Yyymira/TTGO-Macropad/docs/schematic.en.html

English | Español

# Schematic — TTGO Macropad

What goes to each GPIO of the TTGO T-Display for the 10 buttons (6 Cherry MX, the board's 2 built-in buttons and each encoder's push switch) and the rotation of the 2 encoders. Everything is soldered straight to the switch pins, against the same GND bus.

The T-Display's ESP32 in the center, with the 6 Cherry MX keys and the 2 built-in buttons against the GND bus on the left, and the 2 EC11 encoders against the one on the right. The built-in ones (dashed grey) are already on the board; the case presses them with printed plungers.

GPIO to wire Already built into the board Shared GND bus Pin / junction

## Connection table

GPIO | Component | Other terminal | Note
GPIO32 | KEY 1 | GND | Cherry MX, back row, left.
GPIO33 | KEY 2 | GND | Cherry MX, back row, center.
GPIO25 | KEY 3 | GND | Cherry MX, back row, right.
GPIO26 | KEY 4 | GND | Cherry MX, front row, left.
GPIO13 | KEY 5 | GND | Cherry MX, front row, center.
GPIO17 | KEY 6 | GND | Cherry MX, front row, right.
GPIO0 | BOARD 7 | GND | Built in. Don't hold it while resetting/plugging in USB.
GPIO35 | BOARD 8 | GND | Built in.
GPIO27 | ENC 1 · CLK | GND (del encoder) | Back encoder, signal A.
GPIO12 | ENC 1 · DT | GND (del encoder) | Back encoder, signal B.
GPIO21 | ENC 2 · CLK | GND (del encoder) | Front encoder, signal A.
GPIO22 | ENC 2 · DT | GND (del encoder) | Front encoder, signal B.
GPIO15 | ENC 1 · SW | GND | Back encoder's shaft switch (button 9).
GPIO2 | ENC 2 · SW | GND | Front encoder's shaft switch (button 10).

## Parts list

- 6× Cherry MX switches (Brown), plate mount, snapped into the case lid.
- 2× EC11 rotary encoders, preferably with a push switch (3 rotation pins: A – C – B, with C to GND; 2 switch pins). If yours has 3 pins (no switch), don't wire GPIO15 or GPIO2: everything else works the same and buttons 9 and 10 just aren't used.
- Thin wire to solder straight to the pins (no PCB).

## Notes

- Every switch goes to GND using the ESP32's internal pull-up — no resistors or diodes (each key has its own GPIO, there's no matrix).
- The encoders use the same internal pull-up through ESP32Encoder.
- GPIO0 is also the boot button: if you hold it while plugging in USB, the board enters flashing mode instead of booting normally.
- GPIO12, GPIO15 and GPIO2 are also read at boot, but the encoder and the switches only pull them to GND: when released they change nothing. Don't hold encoder 2 pressed while flashing.

Full details and the list of pins free for future use in docs/wiring.en.md, inside ttgo-macropad/.
