Yyymira/TTGO-Macropad/docs/schematic.html

English | Español

# Esquemático — TTGO Macropad

Qué va a cada GPIO del TTGO T-Display para los 10 botones (6 Cherry MX, los 2 integrados de la placa y el pulsador de cada encoder) y el giro de los 2 encoders. Todo se suelda directo a los pines de los switches, contra el mismo bus de GND.

El ESP32 del T-Display al centro, con las 6 teclas Cherry MX y los 2 botones integrados contra el bus de GND de la izquierda, y los 2 encoders EC11 contra el de la derecha. Los integrados (gris punteado) ya están en la placa; el gabinete los acciona con pulsadores impresos.

GPIO a cablear Ya integrado en la placa Bus de GND común Pin / unión

## Tabla de conexión

GPIO | Componente | Otro terminal | Nota
GPIO32 | TECLA 1 | GND | Cherry MX, fila de atrás, izquierda.
GPIO33 | TECLA 2 | GND | Cherry MX, fila de atrás, centro.
GPIO25 | TECLA 3 | GND | Cherry MX, fila de atrás, derecha.
GPIO26 | TECLA 4 | GND | Cherry MX, fila de adelante, izquierda.
GPIO13 | TECLA 5 | GND | Cherry MX, fila de adelante, centro.
GPIO17 | TECLA 6 | GND | Cherry MX, fila de adelante, derecha.
GPIO0 | PLACA 7 | GND | Integrado. No mantener apretado al resetear/conectar USB.
GPIO35 | PLACA 8 | GND | Integrado.
GPIO27 | ENC 1 · CLK | GND (del encoder) | Encoder de atrás, señal A.
GPIO12 | ENC 1 · DT | GND (del encoder) | Encoder de atrás, señal B.
GPIO21 | ENC 2 · CLK | GND (del encoder) | Encoder de adelante, señal A.
GPIO22 | ENC 2 · DT | GND (del encoder) | Encoder de adelante, señal B.
GPIO15 | ENC 1 · SW | GND | Pulsador del eje del encoder de atrás (botón 9).
GPIO2 | ENC 2 · SW | GND | Pulsador del eje del encoder de adelante (botón 10).

## Lista de compras

- 6× switch Cherry MX (Brown), montaje en placa, encastrados en la tapa del gabinete.
- 2× encoder rotativo EC11, mejor con pulsador (3 pines del giro: A – C – B, con C a GND; 2 pines del pulsador). Si el tuyo es de 3 pines (sin pulsador), no cables GPIO15 ni GPIO2: el resto funciona igual y los botones 9 y 10 no se usan.
- Cable fino para soldar directo a los pines (sin PCB).

## Notas

- Todos los switches van a GND usando el pull-up interno del ESP32 — sin resistencias ni diodos (cada tecla tiene su propio GPIO, no hay matriz).
- Los encoders usan la misma lógica de pull-up interno vía ESP32Encoder.
- GPIO0 es también el botón de boot: si lo mantenés apretado al conectar el USB, la placa entra en modo flasheo en vez de arrancar normal.
- GPIO12, GPIO15 y GPIO2 también se leen al arrancar, pero el encoder y los pulsadores solo los llevan a GND: sueltos no cambian nada. No mantengas apretado el encoder 2 mientras flasheás.

Detalle completo y lista de pines libres para el futuro en docs/wiring.md, dentro de ttgo-macropad/.
