Yyymira/TTGO-Macropad/docs/acciones.md

[English](actions.md) | **Español**

# Qué puede hacer cada botón y encoder

En Linux todo se configura desde el widget de Plasma (sección de la capa →
botones y encoders) y se aplica con **Guardar**. En Windows, desde la pestaña
**Configuración** de la app, con **Guardar y aplicar**; el formato es el mismo,
pero entiende menos teclas (ver [En Windows](#en-windows)).

## Tipos de acción de un botón

| En el widget | Qué hace |
|---|---|
| Ninguna | Nada. |
| Tecla / atajo | Aprieta una tecla o una combinación (ver abajo). |
| Ejecutar comando | Ejecuta un comando o script (ver [Ejecutar comandos](#ejecutar-comandos)). |
| Capa siguiente | Pasa a la capa siguiente; desde la última vuelve a la primera. |
| Capa anterior | Pasa a la capa anterior; desde la primera va a la última. |
| Ir a capa… | Salta a una capa fija. **Se cuenta desde 0**: la primera capa es 0, la segunda es 1, etc. |
| Navegador | Una acción en el navegador, con la [extensión](../README.md#extensión-del-navegador): velocidad del video, adelantar/atrasar 10 s, saltar anuncio, volumen de la pestaña, ir a la pestaña que suena, micrófono y cámara de la reunión, o **clic en un botón de una página** que hayas elegido (ver abajo). En los encoders se elige una para cada sentido (por ejemplo, adelantar/atrasar). |
| Cambiar pantalla de reposo | Fija la pantalla de reposo por un rato: cada pulsación pasa a **Auto → Stats → Clima → Multimedia → Auto**, y la placa la muestra enseguida. Es momentáneo: no cambia la configuración, y al reiniciar la PC o la placa vuelve a la configurada. En la placa el botón muestra cuál está activa ("Vista: Clima"), y las pantallas de reposo muestran un indicador chico: **A** si alternan solas, un **pin** si quedó fija (naranja si la fijaste con el botón). |

Son hasta 10 botones por capa: las 6 teclas, los 2 de la placa y el pulsador de
cada encoder ("Encoder 1 (apretar)" y "Encoder 2 (apretar)", al apretar la
perilla). Estos dos últimos existen solo si tus encoders tienen pulsador; si
son de 3 pines, dejalos en "Ninguna". Se configuran todos igual; los de los
encoders vienen sin nada asignado. En la pantalla, los pulsadores de los encoders aparecen en una
columna a la izquierda solo en las capas donde tienen algo asignado.

El giro de cada encoder se configura con **Teclas** (una combinación para el
giro horario y otra para el antihorario; cada "click" la aprieta una vez) o con
**Comandos** (un comando para cada sentido, que se ejecuta en cada "click").

### Alias: cómo se ve en la pantalla

Cada botón tiene un campo **Alias** (al final de su fila en el widget). Si lo
completás, la placa muestra eso en vez de lo automático: por ejemplo
`Pest. ant.` en lugar de `CTRL+SHIFT+TAB`. Hasta 24 caracteres, sin tildes
(las fuentes de la pantalla son básicas).

Sin alias, lo que no entre en la casilla se achica, después se parte en dos
renglones (cortando en los `+`) y, si igual no entra, se recorta con "...".

## Cómo escribir una tecla o un atajo

- Las teclas se separan con **coma**: `ctrl, shift, t`.
- Se aprietan todas juntas en ese orden y se sueltan al revés, igual que hacés
  con la mano. Poné siempre los modificadores primero.
- No importan mayúsculas ni espacios: `Ctrl, T` es lo mismo que `ctrl,t`.
- Si una tecla está mal escrita, ese botón no hace nada (no rompe el resto).
- En la pantalla de la placa se ve el atajo abreviado: `CTRL+SHIFT+T`
  (máximo 14 caracteres).

### Los atajos de KDE valen

El macropad aprieta **teclas reales**, como un teclado más. Así que cualquier
atajo que funcione con tu teclado funciona igual desde el macropad: los de KDE,
los de cada programa, los de juegos, etc. Solo hay que traducir la forma de
escribirlo: donde KDE dice `+`, acá va una coma.

| KDE lo muestra como | En el widget |
|---|---|
| `Meta+E` | `meta, e` |
| `Ctrl+Alt+T` | `ctrl, alt, t` |
| `Meta+L` | `meta, l` |
| `Ctrl+F1` | `ctrl, f1` |
| `Meta+Shift+S` | `meta, shift, s` |
| `Alt+Tab` | `alt, tab` |
| `Imprimir` | `sysrq` |

(Ojo: `Imprimir` / `ImprPant` se llama `sysrq` acá, no `print`.)

### Truco: F13 a F24 para acciones propias

Tu teclado no tiene F13–F24, pero el macropad sí puede mandarlas. Como nadie
más las usa, son ideales para acciones a medida sin chocar con nada:

1. En el widget, asigná a un botón `f13` (o `f14`, …, `f24`).
2. En **Configuración del sistema → Teclado → Atajos de teclado → Agregar
   nuevo → Orden o script**, poné el comando que quieras (abrir una app,
   un script, `systemctl suspend`, etc.).
3. Como atajo, tocá el botón del macropad: KDE lo registra como `F13`.

Así un botón puede hacer cualquier cosa que se pueda escribir como comando.

## Ejecutar comandos

Con **Ejecutar comando** (en un botón) o **Comandos** (en un encoder), escribís
el comando tal cual lo escribirías en una terminal:

| Para… | Comando |
|---|---|
| Abrir una app | `konsole`, `dolphin`, `firefox`, `spotify` |
| Correr un script tuyo | `bash ~/scripts/algo.sh` |
| Abrir una página | `xdg-open https://github.com` |
| Abrir una carpeta | `xdg-open ~/Descargas` |
| Suspender la PC | `systemctl suspend` |
| Volumen de a 5 % (encoder) | horario `wpctl set-volume -l 1 @DEFAULT_AUDIO_SINK@ 5%+`, antihorario `wpctl set-volume @DEFAULT_AUDIO_SINK@ 5%-` |
| Notificación de prueba | `notify-send "Macropad" "¡Funciona!"` |

- Corre con **bash**, como tu usuario y desde tu carpeta personal: funcionan
  `~`, variables, tuberías (`|`), `&&`, etc.
- Cada comando se lanza como un programa independiente, así que reiniciar o
  actualizar el servicio del macropad no cierra lo que abriste.
- Se ejecuta en segundo plano: el macropad no espera a que termine y no se
  ve la salida. Si querés ver qué hace, abrilo en una terminal:
  `konsole --hold -e bash ~/scripts/algo.sh`.
- No hace falta `sudo`. Si un comando lo necesita, no va a funcionar (no hay
  dónde escribir la contraseña).
- En la pantalla de la placa se ve el comando cortado a 14 caracteres.
- En Windows se ejecuta con `cmd.exe` (ej: `notepad`, `start https://github.com`,
  `C:\scripts\algo.bat`).
- En modo Bluetooth (sin la PC) los comandos no hacen nada: el celular no
  puede ejecutar cosas de tu PC.

Los comandos quedan guardados en `~/.config/ttgo-macropad/config.json`, que
solo tu usuario puede leer y modificar.

## Nombres de teclas

### Modificadores

| Escribir | Tecla |
|---|---|
| `ctrl` (o `control`) / `rctrl` | Control izquierdo / derecho |
| `shift` / `rshift` | Shift izquierdo / derecho |
| `alt` / `ralt` | Alt / AltGr |
| `meta` (o `super`, `win`) | Tecla Meta / Windows |

### Letras, números y básicas

| Escribir | Tecla |
|---|---|
| `a` … `z` | Letras |
| `0` … `9` | Números de la fila de arriba |
| `f1` … `f24` | Teclas de función |
| `enter`, `esc`, `tab`, `space`, `backspace` | Las de siempre |
| `delete`, `insert`, `home`, `end`, `pageup`, `pagedown` | Bloque de edición |
| `up`, `down`, `left`, `right` | Flechas |
| `capslock`, `menu`, `sysrq` (Imprimir) | Otras |
| `kp0` … `kp9`, `kpplus`, `kpminus`, `kpasterisk`, `kpslash`, `kpenter`, `kpdot` | Teclado numérico |

### Multimedia y sistema

| Escribir | Qué hace |
|---|---|
| `volumeup` (o `vol+`) / `volumedown` (o `vol-`) | Subir / bajar volumen (con el cartelito de KDE) |
| `mute` | Silenciar |
| `micmute` | Silenciar el micrófono |
| `playpause` (o `play`) | Reproducir / pausar |
| `nextsong` (o `next`) / `previoussong` (o `prev`) | Tema siguiente / anterior |
| `stop` | Detener |
| `brightnessup` / `brightnessdown` | Brillo de pantalla (en monitores que KDE puede controlar) |
| `calc`, `mail`, `homepage`, `search`, `file` | Abren calculadora, correo, navegador, búsqueda, gestor de archivos |
| `zoomin`, `zoomout` | Zoom (donde la app lo soporte) |

### Signos de puntuación

Los signos se escriben por el **nombre de la tecla física** en un teclado
estadounidense, no por el carácter. Con la distribución en español la
misma tecla escribe otra cosa: el macropad aprieta la tecla y el sistema
decide qué carácter sale, igual que con tu teclado.

| Escribir | Tecla física (EE.UU.) | Con distribución española (es) |
|---|---|---|
| `minus` | `-` | `'` |
| `equal` | `=` | `¡` |
| `leftbrace` / `rightbrace` | `[` / `]` | `` ` `` / `+` |
| `semicolon` | `;` | `ñ` |
| `apostrophe` | `'` | `´` |
| `grave` | `` ` `` | `º` |
| `backslash` | `\` | `ç` |
| `comma`, `dot`, `slash` | `,` `.` `/` | `,` `.` `-` |
| `102nd` | (no existe) | `<` |

(Con distribución latinoamericana cambian un poco: si un signo no sale como
esperás, probá con la tecla vecina.)

La lista completa son los nombres `KEY_…` del kernel de Linux, en minúscula
y sin el `KEY_`: cualquiera de ellos funciona.

## Ejemplos listos

| Para… | Botón / encoder | Escribir |
|---|---|---|
| Volumen | Encoder | horario `volumeup`, antihorario `volumedown` |
| Brillo | Encoder | horario `brightnessup`, antihorario `brightnessdown` |
| Zoom | Encoder | horario `ctrl, kpplus`, antihorario `ctrl, kpminus` (el + y − del teclado numérico andan igual con cualquier distribución) |
| Cambiar de pestaña | Encoder | horario `ctrl, tab`, antihorario `ctrl, shift, tab` |
| Cambiar de escritorio virtual | Encoder | horario `meta, ctrl, right`, antihorario `meta, ctrl, left` |
| Scroll de línea de tiempo (video) | Encoder | horario `right`, antihorario `left` |
| Deshacer / rehacer | Encoder | horario `ctrl, shift, z`, antihorario `ctrl, z` |
| Bloquear sesión | Botón | `meta, l` |
| Captura de pantalla (Spectacle) | Botón | `sysrq` o `meta, shift, s` |
| Vista general de ventanas | Botón | `meta, w` |
| Escritorio | Botón | `meta, d` |
| Terminal (Konsole) | Botón | `ctrl, alt, t` |
| Gestor de archivos | Botón | `meta, e` |
| Silenciar micrófono en una llamada | Botón | `micmute` |
| Copiar / pegar | Botones | `ctrl, c` / `ctrl, v` |

Estos son los atajos por defecto de KDE Plasma 6. Si cambiaste alguno,
mirá el tuyo en **Configuración del sistema → Teclado → Atajos de teclado**.

## En Windows

La app de Windows usa el mismo formato (teclas separadas por coma, capas,
"Ir a capa" desde 0) y los atajos de Windows valen igual que los de KDE en
Linux: `Win+E` se escribe `win, e`.

Por ahora entiende **menos nombres de teclas** que Linux:

- Modificadores: `ctrl`, `shift`, `alt` (y sus versiones `l…`/`r…`, como
  `lctrl`, `rshift`, `ralt`), `win` (o `meta`, `super`).
- Letras `a` … `z` y números `0` … `9`.
- `f1` … `f12`.
- `enter`, `esc`, `tab`, `space`, `backspace`, `delete`, flechas, `home`,
  `end`, `pageup`, `pagedown`.
- Multimedia: `volumeup`, `volumedown`, `mute`, `playpause`, `stop`,
  `nextsong`, `previoussong` (con sus alias). El volumen muestra el cartelito
  de Windows.
- `brightnessup` / `brightnessdown`: solo solas (no combinadas con otras
  teclas) y solo en pantallas que Windows deja controlar, normalmente las
  de notebook. En un monitor de escritorio no hacen nada.

No funcionan en Windows: F13–F24, `sysrq`, `insert`, `capslock`, `menu`,
teclado numérico, signos de puntuación, `micmute`, `calc`/`mail`/`homepage`/
`search`/`file` ni `zoomin`/`zoomout`. Un botón con alguna de esas teclas no
hace nada (en Linux sí anda).

Ejemplos con atajos de Windows:

| Para… | Escribir |
|---|---|
| Explorador de archivos | `win, e` |
| Escritorio | `win, d` |
| Bloquear sesión | `win, l` |
| Recorte de pantalla | `win, shift, s` |
| Vista de tareas | `win, tab` |
| Cambiar de escritorio virtual (encoder) | horario `win, ctrl, right`, antihorario `win, ctrl, left` |
| Administrador de tareas | `ctrl, shift, esc` |
| Configuración | `win, i` |

## Botones de páginas ("Clic en…")

Cualquier botón de una página web puede ir a una tecla del macropad, por
ejemplo el **Me gusta** de YouTube:

1. En la página, tocá el ícono de la extensión → **Elegir un botón de esta
   página**.
2. Lo que tenga el mouse encima se resalta en rojo: hacé clic en el botón
   (Esc cancela) y ponele un nombre ("Like").
3. En el widget, elegí la acción **Navegador → Clic en un botón de una
   página…** y, al lado, **Like (youtube.com)**.

Al apretar la tecla, la extensión hace clic en ese botón: en la pestaña que
tenés al frente si es de ese sitio, si no en la que está sonando, si no en
cualquiera del sitio. Funciona aunque estés en otra pestaña.

La extensión guarda una descripción estable del botón (su tipo y los
contenedores que lo rodean), no su texto, porque muchos cambian (el Me gusta
incluye la cantidad de likes). Si un sitio se rediseña y el botón deja de
encontrarse, aparece un cartel en la página: volvé a elegirlo. Los botones
guardados se ven y se borran desde el ícono de la extensión.

## Capas por programa

Cada capa puede activarse sola cuando un programa pasa a primer plano. En el
widget, debajo del destino de la capa, está **"Pasar a esta capa sola con
estos programas"**: escribí los nombres separados por coma (`firefox,
org.kde.dolphin`), o tocá el botón **+** que aparece al lado, que agrega el
programa que tenías en primer plano antes de abrir el widget.

- Al entrar al programa, la placa muestra la capa nueva unos segundos.
- Al salir a un programa sin capa propia (o al escritorio), vuelve a la capa
  que tenías antes.
- Si mientras estás en el programa cambiás de capa a mano, se respeta: al
  salir te quedás en la que elegiste.
- No importan mayúsculas. Sirve tanto el nombre largo (`org.kde.dolphin`)
  como el corto (`dolphin`).

En KDE esto funciona con un script chico de KWin que instala
`linux/install.sh` ("TTGO Macropad: ventana activa", en **Configuración del
sistema → Ventanas → Scripts de KWin**): en Wayland, solo KWin sabe qué
ventana está activa. En Windows se usa el nombre del ejecutable
(`firefox.exe`, `spotify.exe`) y se configura en la pestaña Configuración.

## Capas para el celular

Cada capa tiene un destino: **"Las teclas van a: PC"** (el normal) o
**"Celular (Bluetooth)"**. En una capa de celular, con la placa enchufada a
la PC, las teclas y los encoders salen por el Bluetooth de la placa hacia el
celular en vez de escribirse en la PC. Así podés tener, por ejemplo, una capa
"Spotify del celular" y pasar a ella con "Capa siguiente" sin desenchufar
nada.

- Los cambios de capa siguen funcionando igual, así que podés ir y volver
  entre capas de PC y de celular.
- Las teclas que entiende son las del modo Bluetooth (ver abajo).
- "Ejecutar comando" en una capa de celular sigue ejecutando el comando en la
  PC: el celular no puede ejecutar comandos.
- En la pantalla, una capa de celular muestra la batería y "BT" (celeste si
  hay un celular conectado) arriba a la derecha; en la lista del widget
  aparece con "· BT".
- Sin la PC, todas las capas van al celular, sea cual sea su destino.

## Sin la PC: modo Bluetooth

Cuando la placa funciona sola como teclado Bluetooth (para el celular), usa
las mismas capas, pero entiende **menos teclas**:

- Modificadores (`ctrl`, `shift`, `alt`, `meta` y sus variantes).
- Letras, números y signos de **un solo carácter** escritos tal cual
  (`a`, `7`, `-`, `.`), no por nombre (`minus` no anda en Bluetooth).
- `enter`, `esc`, `tab`, `space`, `backspace`, `delete`, flechas, `home`,
  `end`, `pageup`, `pagedown`, `f1` … `f12`.
- Multimedia: `playpause`, `stop`, `next`, `prev`, `mute`, `volumeup`,
  `volumedown` (con sus alias).

No hay brillo, F13–F24, `micmute`, `sysrq` ni las de aplicaciones
(`calc`, `mail`…). Un botón con alguna de esas teclas no hace nada en modo
Bluetooth, pero sigue funcionando normal con la PC.

En Android, apps como **Key Mapper** (gratis y de código abierto) convierten
una tecla de un teclado externo en una acción: asignale a un botón una tecla
que no uses para escribir (por ejemplo `f9`) y en Key Mapper configurá
"F9 → abrir Spotify".
