Yyymira/TTGO-Macropad/gabinete/img/lateral.png

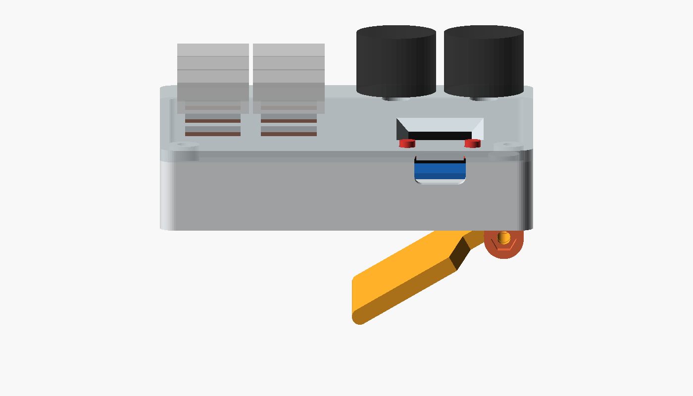
gabinete/img/lateral.png
