Yyymira/TTGO-Macropad/gabinete/img/tapa_abajo.png

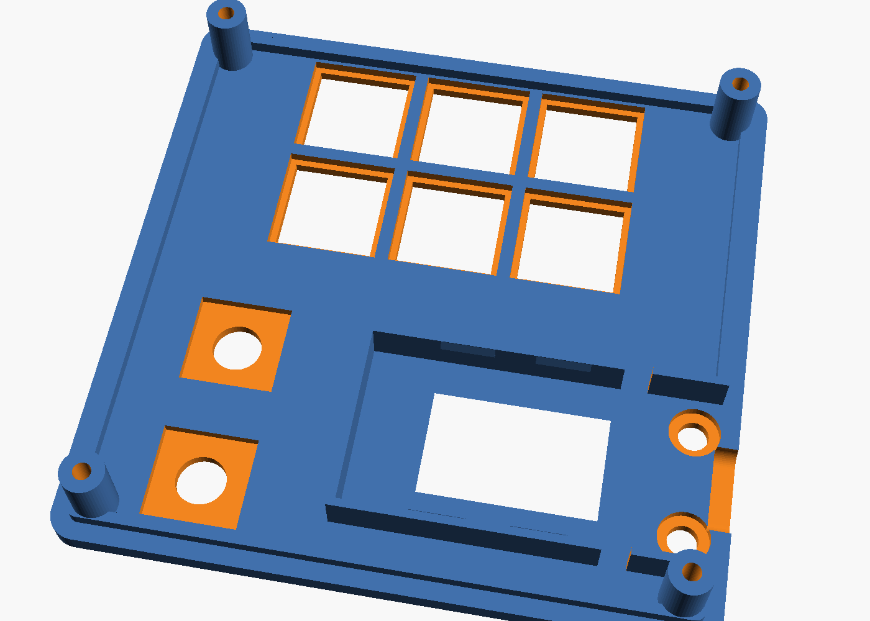
gabinete/img/tapa_abajo.png
