Yyymira/TTGO-Macropad/gabinete/stl/tapa.stl

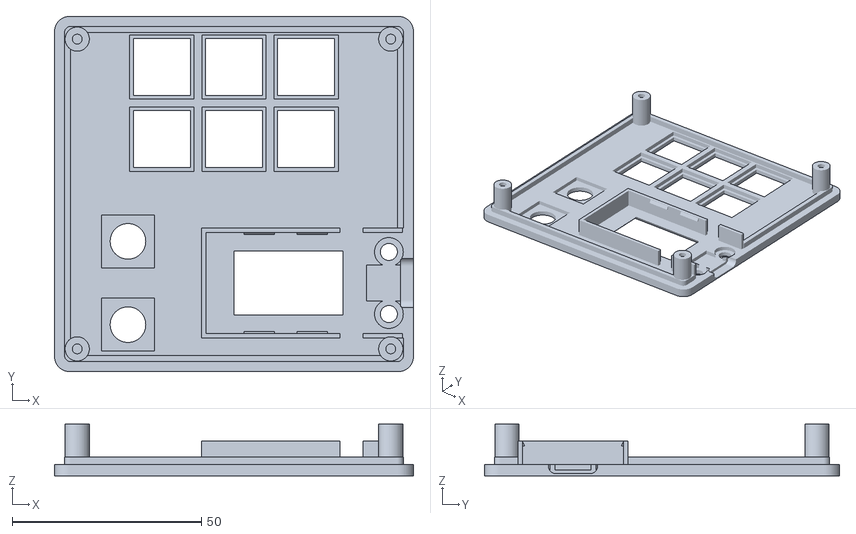
[picture p10: CAD file, 2026-10-21]
gabinete/stl/tapa.stl
94.8 x 93.8 x 13.7
