Yyymira/TTGO-Macropad/gabinete/stl/prueba_mx_enc.stl

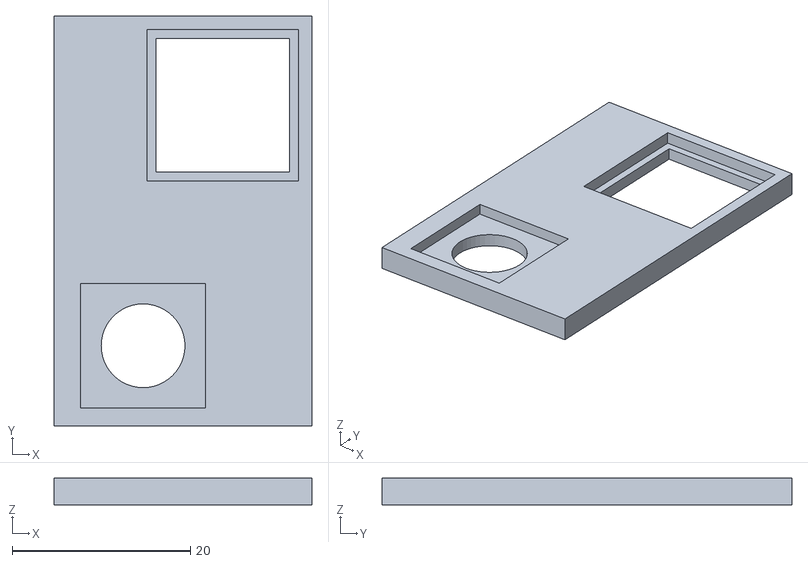
[picture p11: CAD file, 2026-10-21]
gabinete/stl/prueba_mx_enc.stl
28.9 x 46.0 x 3.00
