Yyymira/TTGO-Macropad/gabinete/stl/prueba_ttgo.stl

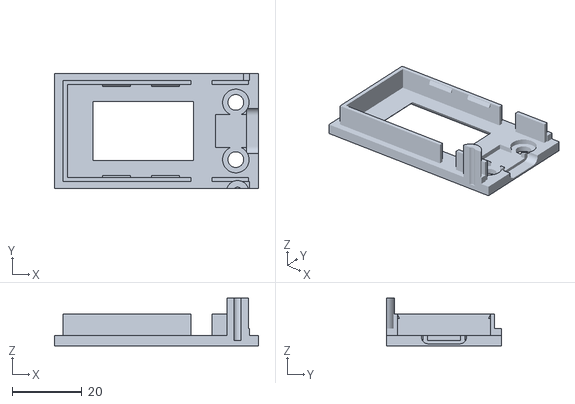
[picture p12: CAD file, 2026-10-21]
gabinete/stl/prueba_ttgo.stl
58.5 x 33.1 x 13.7
