Yyymira/TTGO-Macropad/gabinete/stl/bisagra.stl

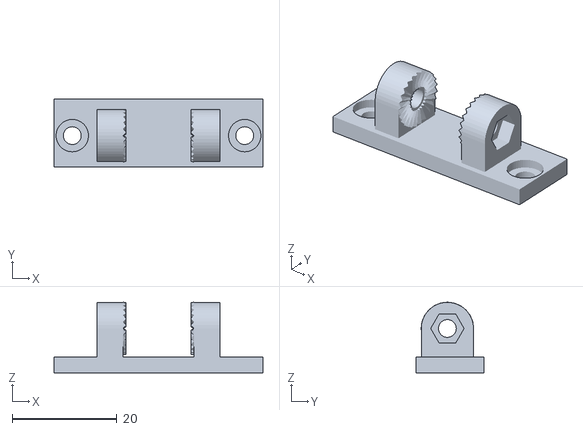
[picture p13: CAD file, 2026-10-20]
gabinete/stl/bisagra.stl
40.0 x 13.0 x 13.5
