Yyymira/TTGO-Macropad/gabinete/stl/base.stl

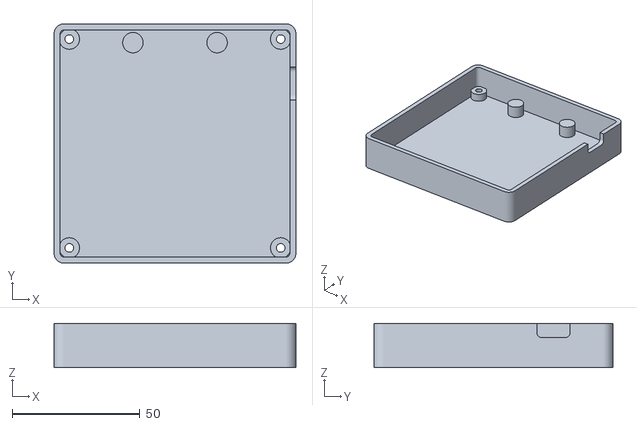
[picture p14: CAD file, 2026-10-20]
gabinete/stl/base.stl
94.8 x 93.8 x 17.4
