Yyymira/TTGO-Macropad/gabinete/stl/pulsador.stl

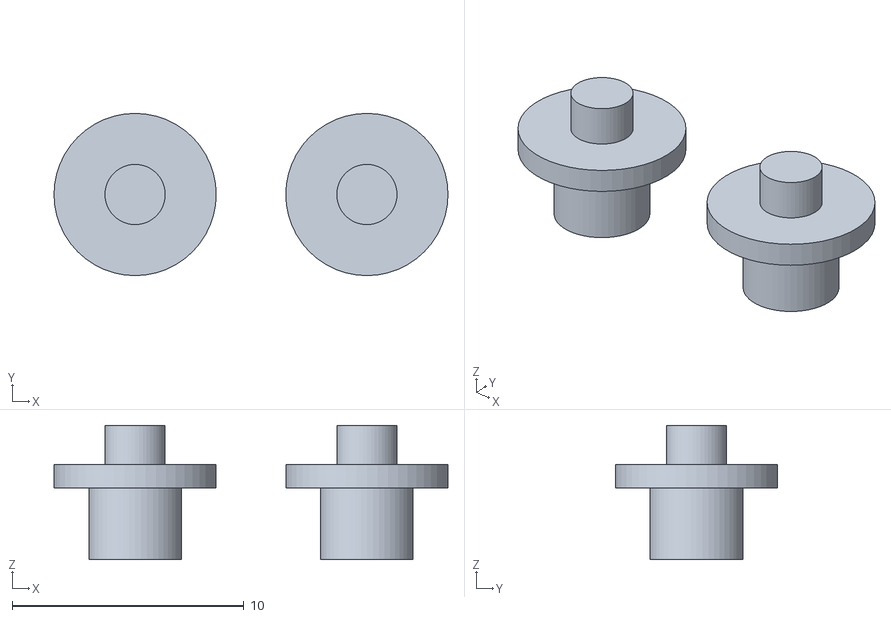
[picture p15: CAD file, 2026-10-20]
gabinete/stl/pulsador.stl
17.0 x 7.00 x 5.80
