Yyymira/TTGO-Macropad/gabinete/stl/pata.stl

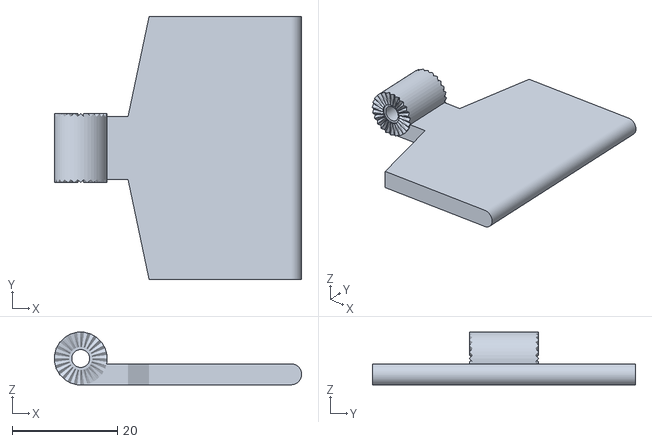
[picture p16: CAD file, 2026-10-20]
gabinete/stl/pata.stl
47.0 x 50.0 x 10.0
