Yyymira/TTGO-Macropad/desktop-app/macropad/ui/config_tab.py

"""Editor de capas y mapeos de botones/encoders.
Los cambios quedan en un borrador local hasta apretar 'Guardar y aplicar',
que persiste a disco y le avisa al Controller para que lo use ya mismo."""

import copy

from PySide6.QtWidgets import (
    QComboBox,
    QFormLayout,
    QGridLayout,
    QGroupBox,
    QHBoxLayout,
    QInputDialog,
    QLabel,
    QLineEdit,
    QListWidget,
    QMessageBox,
    QPushButton,
    QSpinBox,
    QVBoxLayout,
    QWidget,
)

from macropad.config import NUM_BUTTONS, NUM_ENCODERS
from macropad.controller import Controller
from macropad.i18n import tr

ACTION_CHOICES = [
    (tr("None"), "none"),
    (tr("Key / shortcut"), "key"),
    (tr("Run command"), "command"),
    (tr("Browser"), "browser"),
    (tr("Next layer"), "layer_next"),
    (tr("Previous layer"), "layer_prev"),
    (tr("Go to layer N"), "layer_set"),
    (tr("Switch idle screen"), "idle_view"),
]


def _action_to_combo_value(action: dict) -> tuple[str, str]:
    kind = action.get("action", "none")
    if kind == "key":
        return kind, ",".join(action.get("keys", []))
    if kind in ("command", "browser"):
        return kind, action.get("cmd", "")
    if kind == "layer_set":
        return kind, str(action.get("index", 0))
    return kind, ""


def _combo_value_to_action(kind: str, value: str) -> dict:
    if kind == "key":
        keys = [k.strip() for k in value.split(",") if k.strip()]
        return {"action": "key", "keys": keys}
    if kind in ("command", "browser"):
        return {"action": kind, "cmd": value.strip()}
    if kind == "layer_set":
        try:
            idx = int(value.strip() or 0)
        except ValueError:
            idx = 0
        return {"action": "layer_set", "index": idx}
    return {"action": kind}


class ButtonRow(QWidget):
    def __init__(self, label: str):
        super().__init__()
        self.combo = QComboBox()
        for text, _ in ACTION_CHOICES:
            self.combo.addItem(text)
        self.alias_edit = QLineEdit()
        self.alias_edit.setPlaceholderText(tr("Alias"))
        self.alias_edit.setMaxLength(24)
        self.value_edit = QLineEdit()
        self.value_edit.setPlaceholderText(tr("e.g. ctrl,t  or  playpause  (or the command to run, or a browser action)"))

        row = QHBoxLayout(self)
        row.addWidget(QLabel(label), 0)
        row.addWidget(self.combo, 1)
        row.addWidget(self.value_edit, 2)
        row.addWidget(self.alias_edit, 1)

    def set_action(self, action: dict) -> None:
        kind, value = _action_to_combo_value(action)
        for i, (_, k) in enumerate(ACTION_CHOICES):
            if k == kind:
                self.combo.setCurrentIndex(i)
                break
        self.value_edit.setText(value)
        self.alias_edit.setText(action.get("label", ""))

    def get_action(self) -> dict:
        kind = ACTION_CHOICES[self.combo.currentIndex()][1]
        action = _combo_value_to_action(kind, self.value_edit.text())
        if self.alias_edit.text().strip():
            action["label"] = self.alias_edit.text().strip()
        return action


class EncoderRow(QWidget):
    def __init__(self, label: str):
        super().__init__()
        self.type_combo = QComboBox()
        self.type_combo.addItems([tr("Keys"), tr("Commands")])
        self.cw_edit = QLineEdit()
        self.cw_edit.setPlaceholderText(tr("clockwise, e.g. volumeup"))
        self.ccw_edit = QLineEdit()
        self.ccw_edit.setPlaceholderText(tr("counterclockwise, e.g. volumedown"))

        row = QHBoxLayout(self)
        row.addWidget(QLabel(label), 0)
        row.addWidget(self.type_combo, 0)
        row.addWidget(QLabel(tr("Clockwise:")))
        row.addWidget(self.cw_edit, 1)
        row.addWidget(QLabel(tr("Counterclockwise:")))
        row.addWidget(self.ccw_edit, 1)

    def set_mapping(self, mapping: dict) -> None:
        if mapping.get("type") == "command":
            self.type_combo.setCurrentIndex(1)
            self.cw_edit.setText(mapping.get("cw_cmd", ""))
            self.ccw_edit.setText(mapping.get("ccw_cmd", ""))
        else:
            self.type_combo.setCurrentIndex(0)
            self.cw_edit.setText(",".join(mapping.get("cw", [])))
            self.ccw_edit.setText(",".join(mapping.get("ccw", [])))

    def get_mapping(self) -> dict:
        if self.type_combo.currentIndex() == 1:
            return {"type": "command", "cw": [], "ccw": [],
                    "cw_cmd": self.cw_edit.text().strip(), "ccw_cmd": self.ccw_edit.text().strip()}
        cw = [k.strip() for k in self.cw_edit.text().split(",") if k.strip()]
        ccw = [k.strip() for k in self.ccw_edit.text().split(",") if k.strip()]
        return {"cw": cw, "ccw": ccw}


class ConfigTab(QWidget):
    def __init__(self, controller: Controller):
        super().__init__()
        self.controller = controller
        self.draft = copy.deepcopy(controller.config)

        self.layer_list = QListWidget()
        btn_add = QPushButton(tr("+ Layer"))
        btn_add.clicked.connect(self.add_layer)
        btn_del = QPushButton(tr("- Layer"))
        btn_del.clicked.connect(self.remove_layer)
        btn_rename = QPushButton(tr("Rename"))
        btn_rename.clicked.connect(self.rename_layer)

        layer_buttons = QHBoxLayout()
        layer_buttons.addWidget(btn_add)
        layer_buttons.addWidget(btn_del)
        layer_buttons.addWidget(btn_rename)

        left = QVBoxLayout()
        left.addWidget(QLabel(tr("Layers")))
        left.addWidget(self.layer_list)
        left.addLayout(layer_buttons)

        names = [tr("Key {n}", n=i + 1) for i in range(6)] + [
            tr("Board (GPIO0)"), tr("Board (GPIO35)"), tr("Encoder 1 (press)"), tr("Encoder 2 (press)")]
        self.button_rows = [ButtonRow(name) for name in names[:NUM_BUTTONS]]
        buttons_box = QGroupBox(tr("Buttons of the selected layer"))
        buttons_layout = QVBoxLayout()
        for row in self.button_rows:
            buttons_layout.addWidget(row)
        buttons_box.setLayout(buttons_layout)

        enc_names = [tr("Encoder 1 (back)"), tr("Encoder 2 (front)")]
        self.encoder_rows = [EncoderRow(name) for name in enc_names[:NUM_ENCODERS]]
        encoders_box = QGroupBox(tr("Encoders of the selected layer"))
        encoders_layout = QVBoxLayout()
        for row in self.encoder_rows:
            encoders_layout.addWidget(row)
        encoders_box.setLayout(encoders_layout)

        self.idle_spin = QSpinBox()
        self.idle_spin.setRange(3, 600)
        self.idle_spin.setSuffix(" s")

        self.target_combo = QComboBox()
        self.target_combo.addItems([tr("PC"), tr("Phone (Bluetooth)")])

        global_form = QFormLayout()
        global_form.addRow(tr("Keys go to:"), self.target_combo)
        self.apps_edit = QLineEdit()
        self.apps_edit.setPlaceholderText(tr("e.g. firefox.exe, spotify.exe"))
        global_form.addRow(tr("Switch to this layer with programs:"), self.apps_edit)
        global_form.addRow(tr("Idle timeout (back to stats):"), self.idle_spin)

        save_btn = QPushButton(tr("Save and apply"))
        save_btn.clicked.connect(self.save)

        right = QVBoxLayout()
        right.addWidget(buttons_box)
        right.addWidget(encoders_box)
        right.addLayout(global_form)
        right.addWidget(save_btn)

        root = QGridLayout(self)
        root.addLayout(left, 0, 0)
        root.addLayout(right, 0, 1)
        root.setColumnStretch(0, 1)
        root.setColumnStretch(1, 3)

        self.layer_list.currentRowChanged.connect(self._load_layer_into_form)
        self._refresh_layer_list()
        self.idle_spin.setValue(self.draft.get("idle_timeout_sec", 15))
        if self.draft["layers"]:
            self.layer_list.setCurrentRow(0)

    def _refresh_layer_list(self) -> None:
        self.layer_list.blockSignals(True)
        self.layer_list.clear()
        for layer in self.draft["layers"]:
            self.layer_list.addItem(layer.get("name", tr("Unnamed")))
        self.layer_list.blockSignals(False)

    def _current_layer_index(self) -> int:
        return self.layer_list.currentRow()

    def _save_form_into_draft(self, index: int) -> None:
        if not (0 <= index < len(self.draft["layers"])):
            return
        layer = self.draft["layers"][index]
        layer["buttons"] = [row.get_action() for row in self.button_rows]
        layer["encoders"] = [row.get_mapping() for row in self.encoder_rows]
        layer["target"] = "phone" if self.target_combo.currentIndex() == 1 else "pc"
        layer["apps"] = [a.strip() for a in self.apps_edit.text().split(",") if a.strip()]

    def _load_layer_into_form(self, index: int) -> None:
        # Antes de cambiar de capa, persistimos lo editado de la anterior.
        prev = getattr(self, "_last_index", -1)
        if prev != -1:
            self._save_form_into_draft(prev)
        self._last_index = index

        if not (0 <= index < len(self.draft["layers"])):
            return
        layer = self.draft["layers"][index]
        self.target_combo.setCurrentIndex(1 if layer.get("target") == "phone" else 0)
        self.apps_edit.setText(", ".join(layer.get("apps", [])))
        buttons = layer.get("buttons", [])
        for i, row in enumerate(self.button_rows):
            row.set_action(buttons[i] if i < len(buttons) else {"action": "none"})
        encoders = layer.get("encoders", [])
        for i, row in enumerate(self.encoder_rows):
            row.set_mapping(encoders[i] if i < len(encoders) else {"cw": [], "ccw": []})

    def add_layer(self) -> None:
        name, ok = QInputDialog.getText(self, tr("New layer"), tr("Layer name:"))
        if not ok or not name.strip():
            return
        self.draft["layers"].append(
            {
                "name": name.strip(),
                "buttons": [{"action": "none"} for _ in range(NUM_BUTTONS)],
                "encoders": [{"cw": [], "ccw": []} for _ in range(NUM_ENCODERS)],
            }
        )
        self._refresh_layer_list()
        self.layer_list.setCurrentRow(len(self.draft["layers"]) - 1)

    def remove_layer(self) -> None:
        index = self._current_layer_index()
        if index < 0 or len(self.draft["layers"]) <= 1:
            QMessageBox.warning(self, tr("Can't delete"), tr("There must be at least one layer."))
            return
        del self.draft["layers"][index]
        self._last_index = -1
        self._refresh_layer_list()
        self.layer_list.setCurrentRow(0)

    def rename_layer(self) -> None:
        index = self._current_layer_index()
        if index < 0:
            return
        current_name = self.draft["layers"][index].get("name", "")
        name, ok = QInputDialog.getText(self, tr("Rename layer"), tr("Name:"), text=current_name)
        if ok and name.strip():
            self.draft["layers"][index]["name"] = name.strip()
            self._refresh_layer_list()
            self.layer_list.setCurrentRow(index)

    def save(self) -> None:
        self._save_form_into_draft(self._current_layer_index())
        self.draft["idle_timeout_sec"] = self.idle_spin.value()
        self.controller.reload_config(copy.deepcopy(self.draft))
        QMessageBox.information(self, tr("Done"), tr("Settings saved and applied."))
