Yyymira/TTGO-Macropad/(commit log)

2026-10-19 Initial commit: firmware + app de escritorio del TTGO Macropad
    Firmware (PlatformIO/ESP32) para el TTGO T-Display: lectura de botones y
    encoders, pantallas idle (gauges de CPU/GPU, RAM, temperaturas) y de capa,
    protocolo JSON sobre serial. App de escritorio (PySide6) con reconexión
    automática, inyección de teclas vía evdev, editor de capas/mapeos y
    máquina de estados de inactividad.
2026-10-20 Agregar soporte para Windows en la app de escritorio
    El inyector de teclas ahora elige backend según sys.platform: evdev/uinput
    en Linux (sin cambios) o la API Win32 (keybd_event + WMI para brillo) en
    Windows, detrás de la misma interfaz KeyInjector. La detección de puerto
    serie pasa de glob("/dev/tty*") a serial.tools.list_ports, que enumera
    COM* en Windows igual que /dev/ttyACM*/ttyUSB* en Linux.
    Claude-Session: https://claude.ai/code/session_01BQFH5Fw1R5JyoyJnjbx9qT
2026-10-20 Agregar gabinete imprimible en 3D (OpenSCAD + STL)
    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
    [base.stl, bisagra.stl, gabinete.scad, pata.stl, prueba_mx_enc.stl, prueba_ttgo.stl, pulsador.stl, tapa.stl]
2026-10-20 Pasar a 6 Cherry MX + 2 botones integrados (8 botones asignables)
    Las teclas 1-6 son Cherry MX en grilla 3x2 (GPIO32/33/25/26/13/17) y los
    botones integrados de la placa (GPIO0/35) pasan a ser el 7 y el 8. Se
    actualizan firmware, pantalla de capa, app, cableado, esquemático y
    gabinete.
    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
    [base.stl, bisagra.stl, gabinete.scad, pata.stl, prueba_mx_enc.stl, prueba_ttgo.stl, pulsador.stl, tapa.stl]
2026-10-20 Linux: servicio de fondo con autoarranque + widget de Plasma
    daemon.py corre sin ventana como servicio systemd de usuario y expone una
    API local (127.0.0.1, con token en XDG_RUNTIME_DIR) que usa el nuevo
    plasmoide para mostrar estado/stats y editar capas desde el panel.
    También corrige la detección de puerto: se filtra por VID USB para no
    conectarse a los /dev/ttyS* legacy.
    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
    [controller.py, serial_link.py]
2026-10-20 Gauges: abrir hacia abajo y llenar de izquierda a derecha
    drawArc de TFT_eSPI mide los ángulos desde las 6 en punto, no desde las 12.
    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
2026-10-20 Agregar uso de VRAM a la pantalla de stats y al widget
    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
2026-10-20 Reloj y clima, teclado Bluetooth autónomo y actualización OTA
    La placa se conecta al WiFi, muestra hora y clima de Open-Meteo, y si la PC
    deja de mandar datos pasa a modo autónomo: reloj/clima en pantalla y las
    teclas por Bluetooth con la copia del mapeo que guarda en NVS. Se suma OTA
    (ota_upload.sh) y la sección "Dispositivo" en el widget. La tabla de
    particiones pasa a min_spiffs porque el firmware ya no entra en 1.2 MB.
    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
2026-10-20 Gabinete: medidas corregidas tras la primera prueba impresa
    Agujero de Cherry MX a 15 mm (vaciado a 17), marco de la TTGO 1 mm más
    ancho y apertura de 4 mm a 11 mm del extremo USB para el botón lateral.
    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
    [base.stl, bisagra.stl, gabinete.scad, pata.stl, prueba_mx_enc.stl, prueba_ttgo.stl, pulsador.stl, tapa.stl]
2026-10-20 Gabinete: rebaje para el USB-C, ranura del botón lateral y agujero del encoder más grandes
    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
    [gabinete.scad, prueba_mx_enc.stl, prueba_ttgo.stl, tapa.stl]
2026-10-20 Gabinete: tapa.stl queda sin regenerar hasta validar las piezas de prueba
    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
    [tapa.stl]
2026-10-21 Docs: guía de acciones y nombres de teclas
    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
2026-10-21 Docs: sección de Windows en la guía de acciones
    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
2026-10-21 Pulsador de los encoders como botones 9 y 10 (GPIO15 / GPIO2)
    Configurables por capa como los demás, sin nada asignado por defecto.
    Firmware 1.2.0: la pantalla de capa muestra una columna para ellos solo si
    tienen algo asignado y achica la fuente de las etiquetas que no entran.
    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
2026-10-21 Gabinete: ventana del display en la posición medida
    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
    [gabinete.scad, prueba_ttgo.stl]
2026-10-21 Gabinete: ventana del display con la medida corregida
    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
    [gabinete.scad, prueba_ttgo.stl]
2026-10-21 Gabinete: ventana del display con las medidas del TTGO case de kamma_cz
    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
    [gabinete.scad, prueba_ttgo.stl]
2026-10-21 Gabinete: tapa.stl regenerada con todas las correcciones
    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
    [prueba_mx_enc.stl, tapa.stl]
2026-10-21 Encoder 1: DT en GPIO12 (GPIO14 no sale a los pines de la T-Display)
    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
2026-10-21 Acción "Ejecutar comando" para botones y encoders
    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
2026-10-21 Indicador de batería, aviso de batería baja y ahorro en crítico (firmware 1.3.0)
    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
2026-10-21 Docs: el pulsador de los encoders es opcional
    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
2026-10-21 README: corregir material
    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
2026-10-21 README: Bluetooth con el celular probado
    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
2026-10-21 README: foto de la actualización por WiFi
    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
2026-10-21 Idioma según el sistema (inglés/español) en widget, app, servicio y pantalla (firmware 1.4.0)
    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
2026-10-21 Documentación en inglés (README, cableado, acciones, gabinete y esquemático)
    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
2026-10-21 Destino por capa: PC o celular (Bluetooth) con la PC conectada (firmware 1.5.0)
    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
2026-10-21 Capas por programa: la ventana activa elige la capa (KWin script en KDE, ejecutable en Windows)
    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
2026-10-21 Duración de cada pantalla en modo ambos, acción para fijar la pantalla de reposo (firmware 1.8.0); el servicio pide la ventana activa al arrancar
    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
2026-10-21 Cambiar pantalla de reposo: ya no muestra la capa (ni por el giro al apretar la perilla); indicador A / pin en las pantallas (firmware 1.8.1)
    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
2026-10-21 Indicador de pantalla fija: pin en pixel art de Yyymira (firmware 1.8.2)
    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
2026-10-22 Pantalla de multimedia con tapa (MPRIS, firmware 1.9.0); los comandos se lanzan con systemd-run para que reiniciar el servicio no los cierre
    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
2026-10-22 Extensión: ignorar videos silenciados (vistas previas), priorizar la pestaña con sonido y cotejar el título con MPRIS; diagnóstico del navegador en /status
    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
2026-10-22 Tapa: la placa confirma cada pedazo y la PC reenvía los perdidos (se perdían bytes mientras la placa dibujaba); diagnóstico de tapa y RAM libre en el reporte de red (firmware 1.10.2)
    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
2026-10-22 Alias por botón y etiquetas que nunca se salen de la casilla (firmware 1.11.0); extensión: elegir botones de páginas y hacer clic desde el macropad
    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
2026-10-22 Widget: "Clic en…" se asigna solo al primer botón guardado y el menú arranca en "Elegí…" (antes podía quedar sin destino)
    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
